8-semester-iu4-2024-2025/ieevs_homework/(list of files, drawings)

Other design files:
hardware/modeling/Круглов_ИУ4-83Б_ДЗ_БП.pdsprj
hardware/pcb/project/ieevs.PrjPcb
hardware/pcb/project/pcb.PcbDoc
hardware/pcb/project/principal.SchDoc
